erdoganeray/iot-air-conditioner/cnc_paket/hub/2_gorseller/bakir_alt_aynali.png

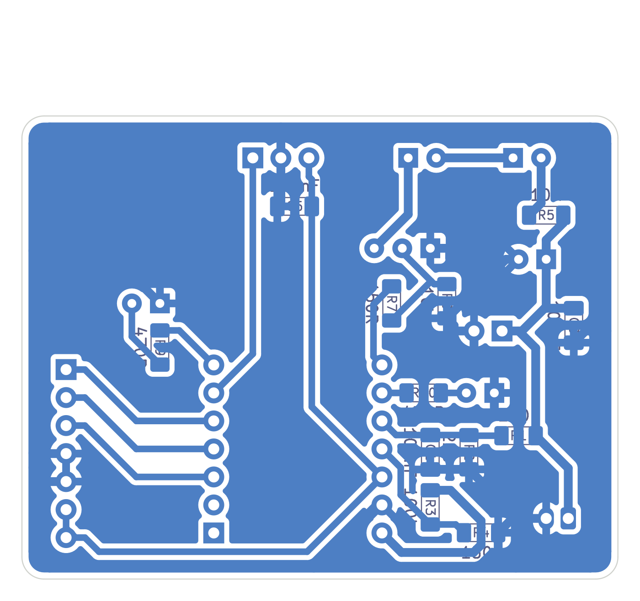
cnc_paket/hub/2_gorseller/bakir_alt_aynali.png
