erdoganeray/iot-air-conditioner/cnc_paket/hub/2_gorseller/yerlesim_ust.png

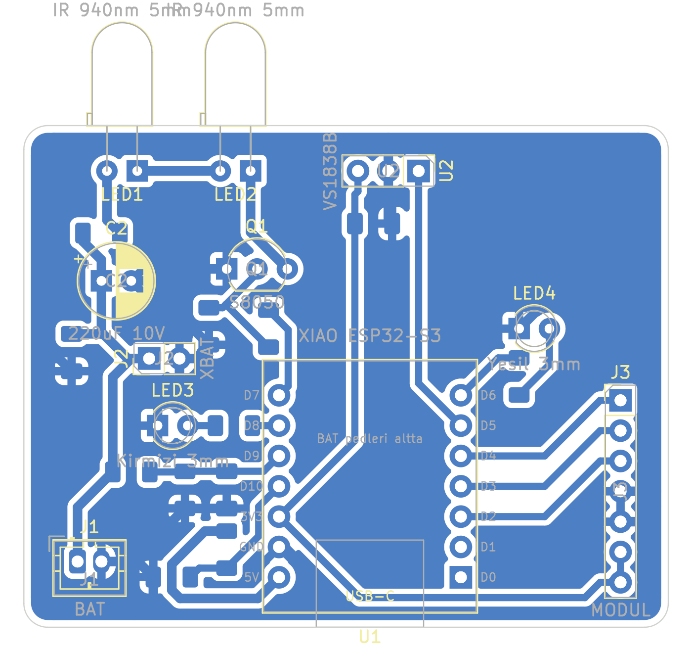
cnc_paket/hub/2_gorseller/yerlesim_ust.png
