erdoganeray/iot-air-conditioner/cnc_paket/sensor/2_gorseller/bakir_alt_aynali.png

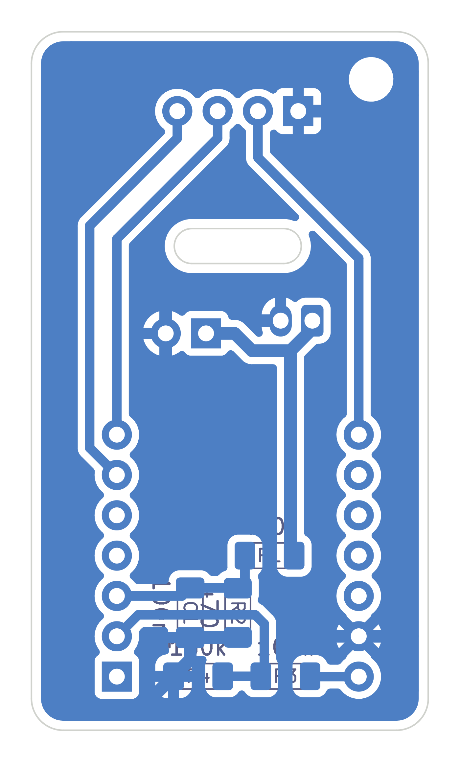
cnc_paket/sensor/2_gorseller/bakir_alt_aynali.png
