erdoganeray/iot-air-conditioner/cnc_paket/sensor/2_gorseller/yerlesim_ust.png

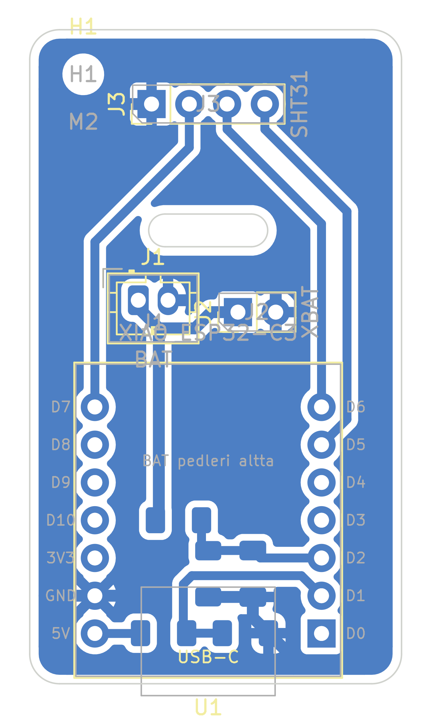
cnc_paket/sensor/2_gorseller/yerlesim_ust.png
