erdoganeray/iot-air-conditioner/enclosure/onizleme/hub_kapali_arka.png

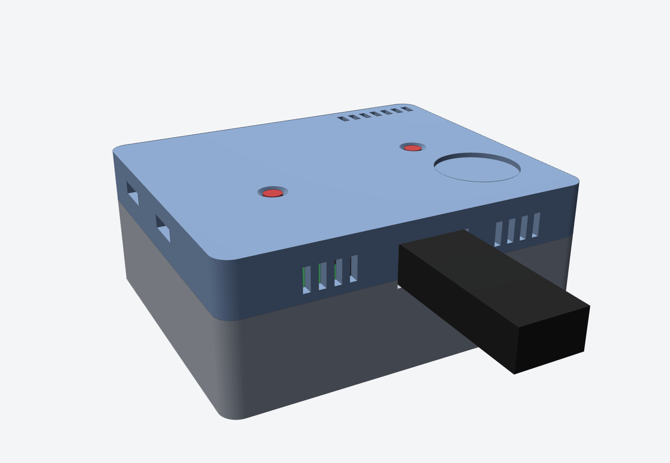
enclosure/onizleme/hub_kapali_arka.png
