erdoganeray/iot-air-conditioner/enclosure/onizleme/hub_kesit.png

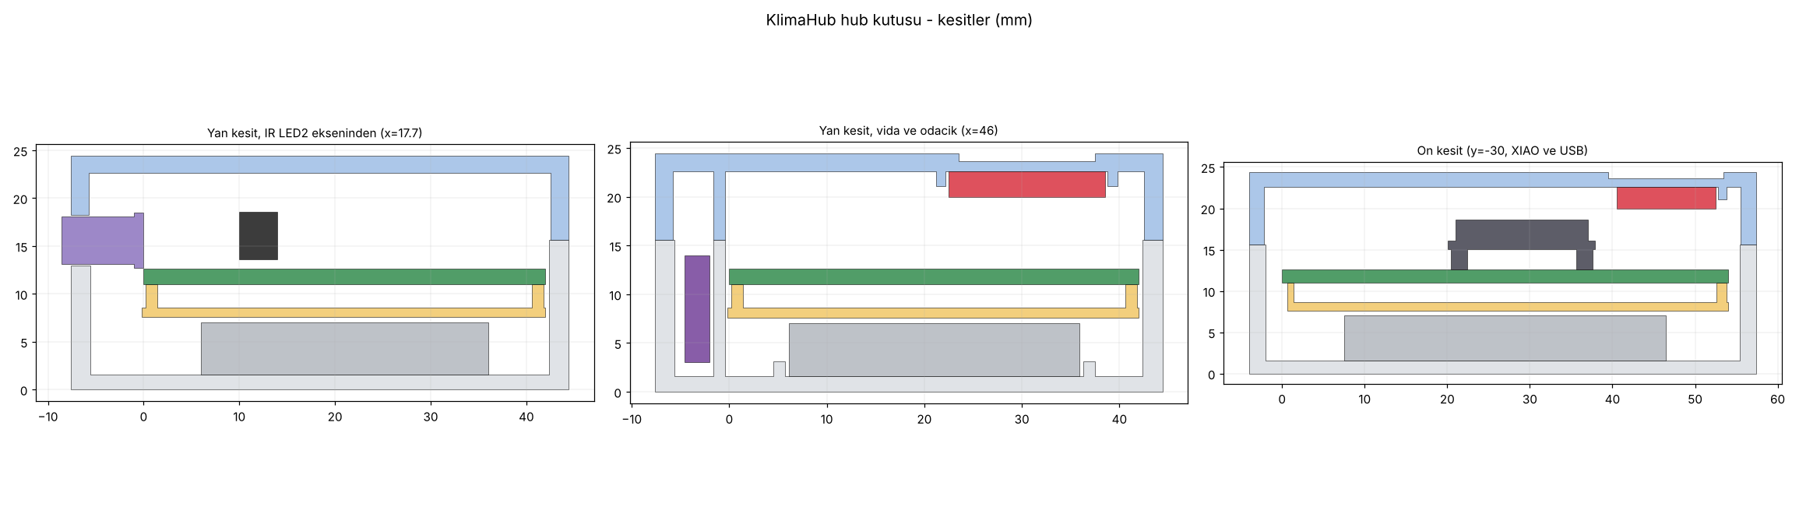
enclosure/onizleme/hub_kesit.png
