erdoganeray/iot-air-conditioner/enclosure/onizleme/sensor_kapali_arka.png

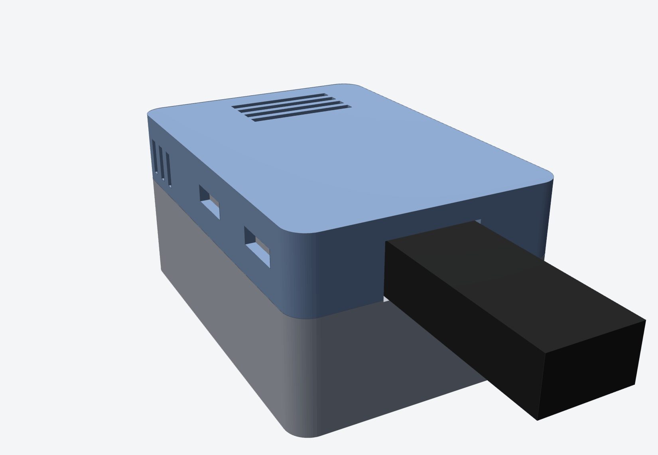
enclosure/onizleme/sensor_kapali_arka.png
