erdoganeray/iot-air-conditioner/enclosure/onizleme/sensor_kesit.png

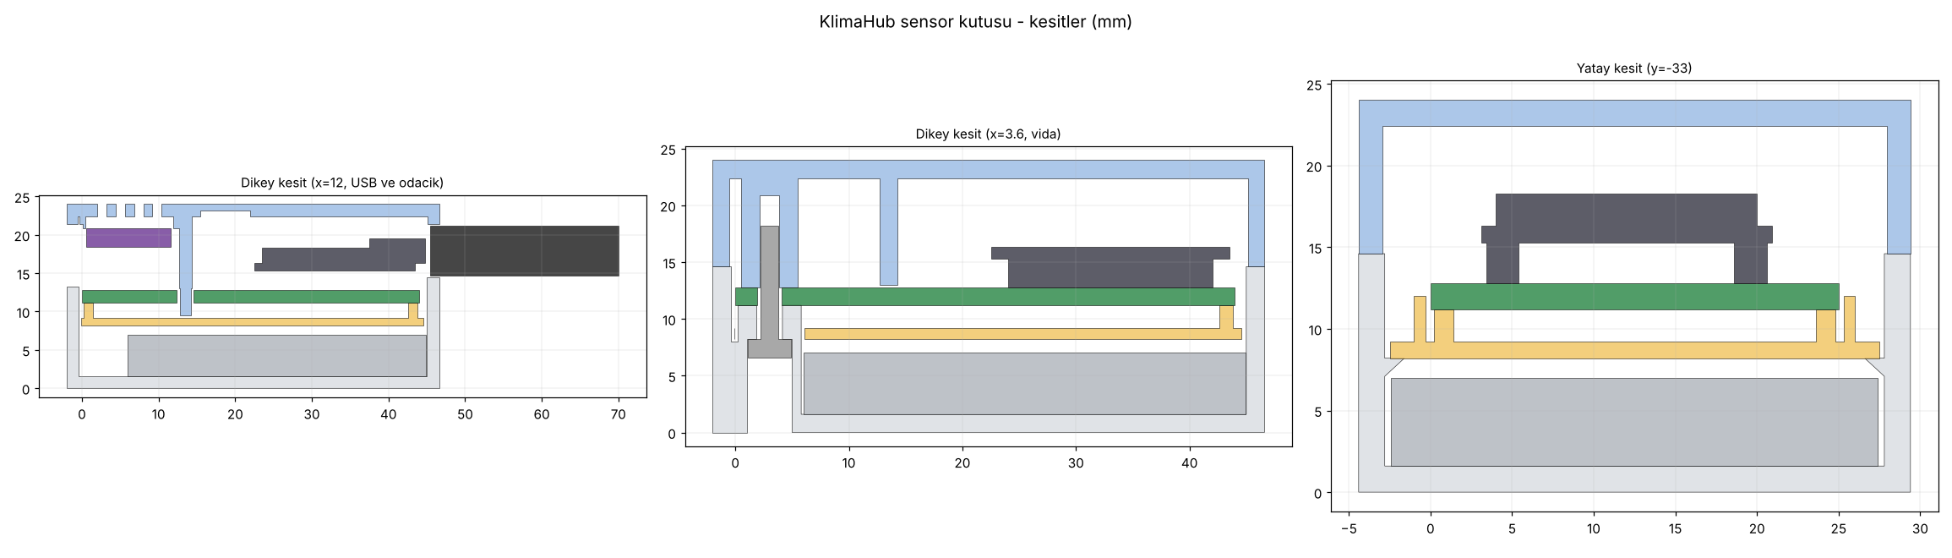
enclosure/onizleme/sensor_kesit.png
