erdoganeray/iot-air-conditioner/pcb/fab/uretim/hub/hub_alt.png

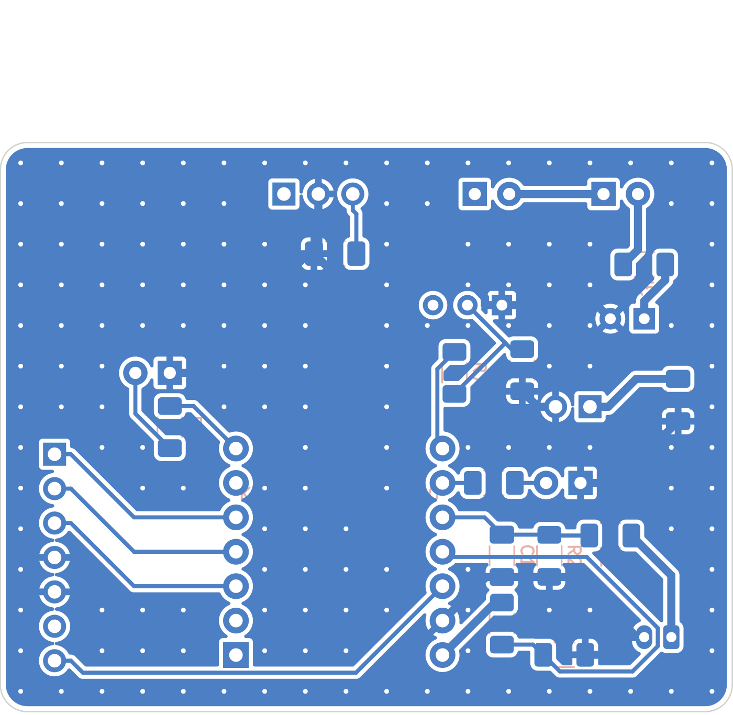
pcb/fab/uretim/hub/hub_alt.png
