erdoganeray/iot-air-conditioner/pcb/fab/uretim/sensor/sensor_alt.png

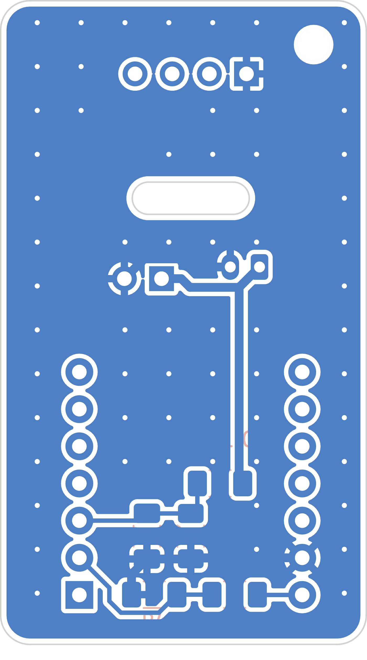
pcb/fab/uretim/sensor/sensor_alt.png
