erdoganeray/iot-air-conditioner/enclosure/hub/hub_montaj.step

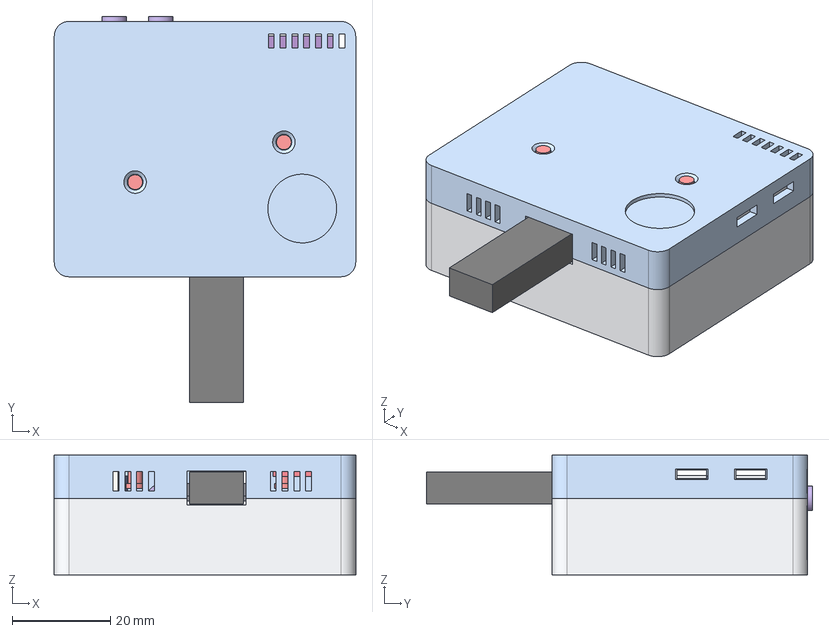
[picture p22: CAD file, 2026-10-21]
enclosure/hub/hub_montaj.step
61.4 x 78.6 x 24.4 mm
alt_govde
kapak
ara_plaka
temsili_kart
temsili_xiao
temsili_usb_fis
temsili_ir_led
temsili_ir_alici
temsili_q1
temsili_c2
temsili_pil_soketi
temsili_durum_led
temsili_ttp223
temsili_sht31
temsili_pil
temsili_vida
