erdoganeray/iot-air-conditioner/enclosure/sensor/sensor_arka_govde.step

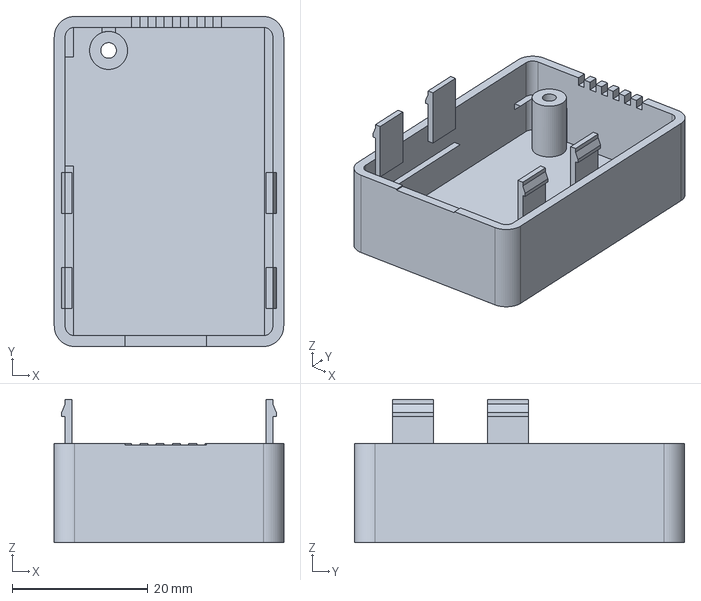
[picture p23: CAD file, 2026-10-21]
enclosure/sensor/sensor_arka_govde.step
33.8 x 48.6 x 21.1 mm
