erdoganeray/iot-air-conditioner/enclosure/hub/hub_kapak.step

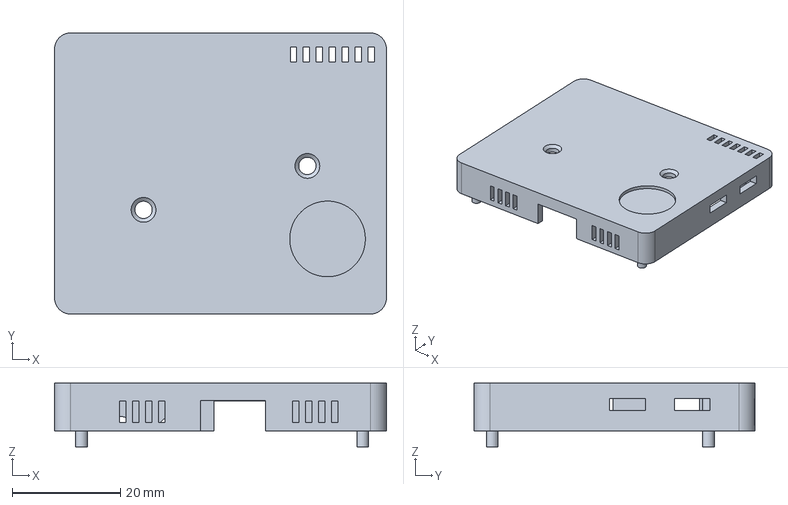
[picture p24: CAD file, 2026-10-21]
enclosure/hub/hub_kapak.step
61.4 x 52.0 x 11.7 mm
