erdoganeray/iot-air-conditioner/enclosure/sensor/sensor_ara_plaka.step

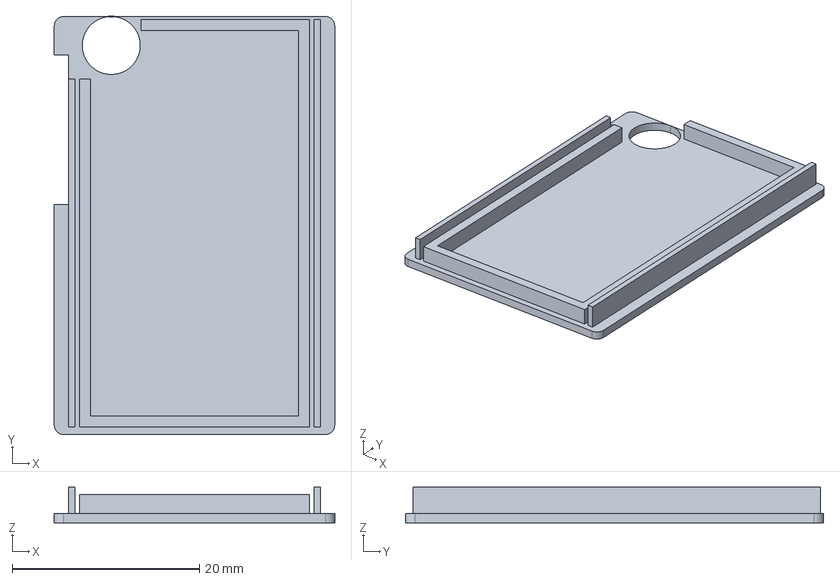
[picture p25: CAD file, 2026-10-21]
enclosure/sensor/sensor_ara_plaka.step
30.0 x 44.7 x 3.80 mm
