erdoganeray/iot-air-conditioner/enclosure/hub/hub_alt_govde.step

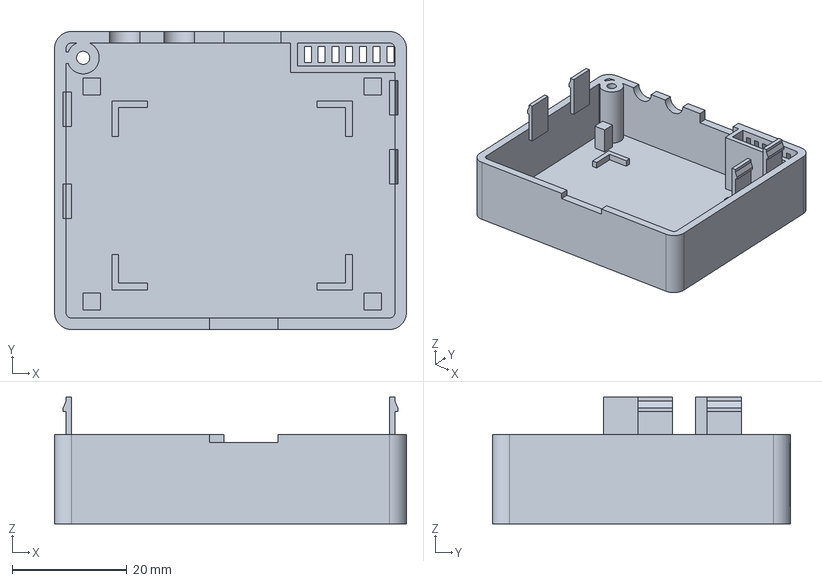
[picture p26: CAD file, 2026-10-21]
enclosure/hub/hub_alt_govde.step
61.4 x 52.0 x 22.1 mm
