erdoganeray/iot-air-conditioner/enclosure/sensor/sensor_on_kapak.step

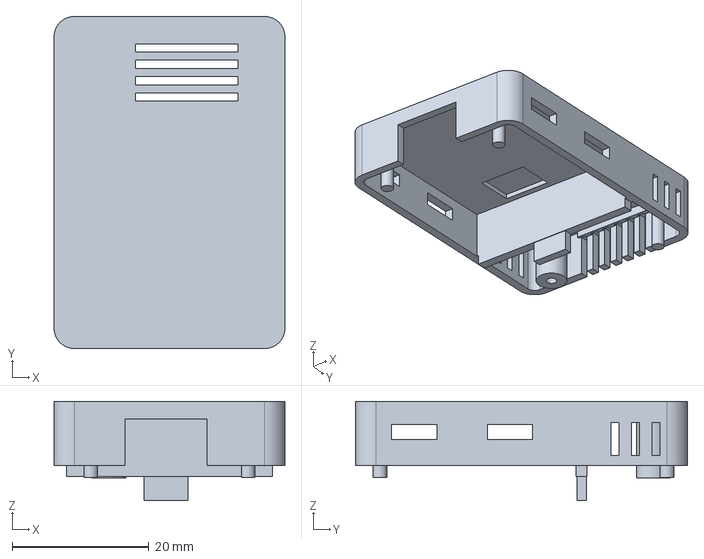
[picture p27: CAD file, 2026-10-21]
enclosure/sensor/sensor_on_kapak.step
33.8 x 48.6 x 14.5 mm
