erdoganeray/iot-air-conditioner/enclosure/hub/hub_ara_plaka.step

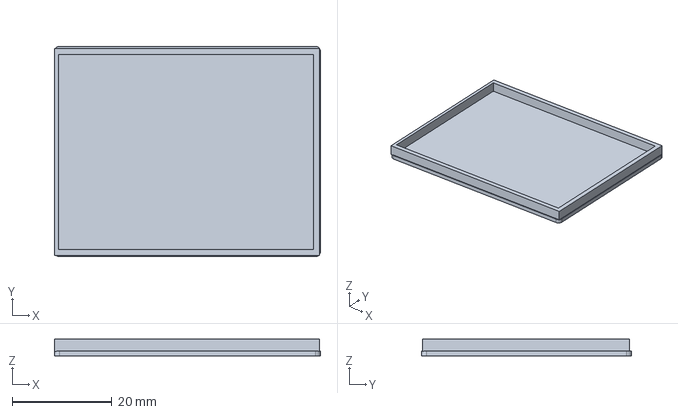
[picture p28: CAD file, 2026-10-21]
enclosure/hub/hub_ara_plaka.step
53.4 x 42.2 x 3.40 mm
