erdoganeray/iot-air-conditioner/enclosure/sensor/sensor_montaj.step

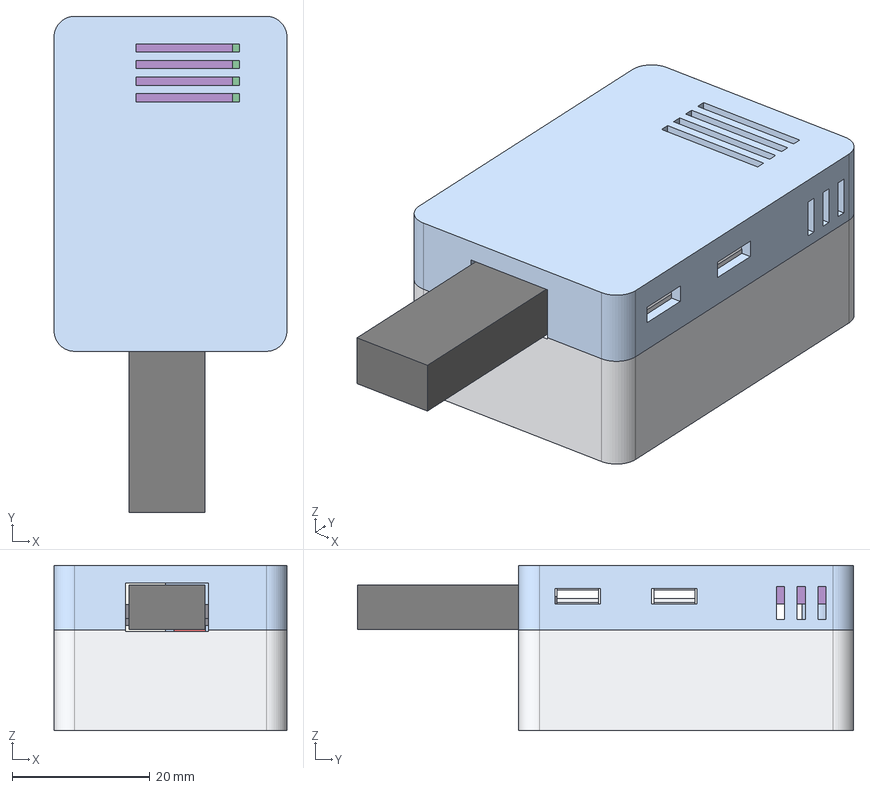
[picture p29: CAD file, 2026-10-21]
enclosure/sensor/sensor_montaj.step
33.8 x 72.0 x 24.0 mm
arka_govde
on_kapak
ara_plaka
temsili_kart
temsili_xiao
temsili_usb_fis
temsili_pil
temsili_sht31
temsili_pil_soketi
temsili_j2_kablo
temsili_vida
