erdoganeray/iot-air-conditioner/(list of files, cad)

Other CAD files:
enclosure/hub/hub_alt_govde.stl
enclosure/hub/hub_ara_plaka.stl
enclosure/hub/hub_kapak.stl
enclosure/sensor/sensor_ara_plaka.stl
enclosure/sensor/sensor_arka_govde.stl
enclosure/sensor/sensor_on_kapak.stl
