erdoganeray/iot-air-conditioner/cnc_paket/yeniden_uretim/pcb/hub/klima-hub.kicad_pcb

## KiCad design cnc_paket/yeniden_uretim/pcb/hub/klima-hub.kicad_pcb (2026-10-21)

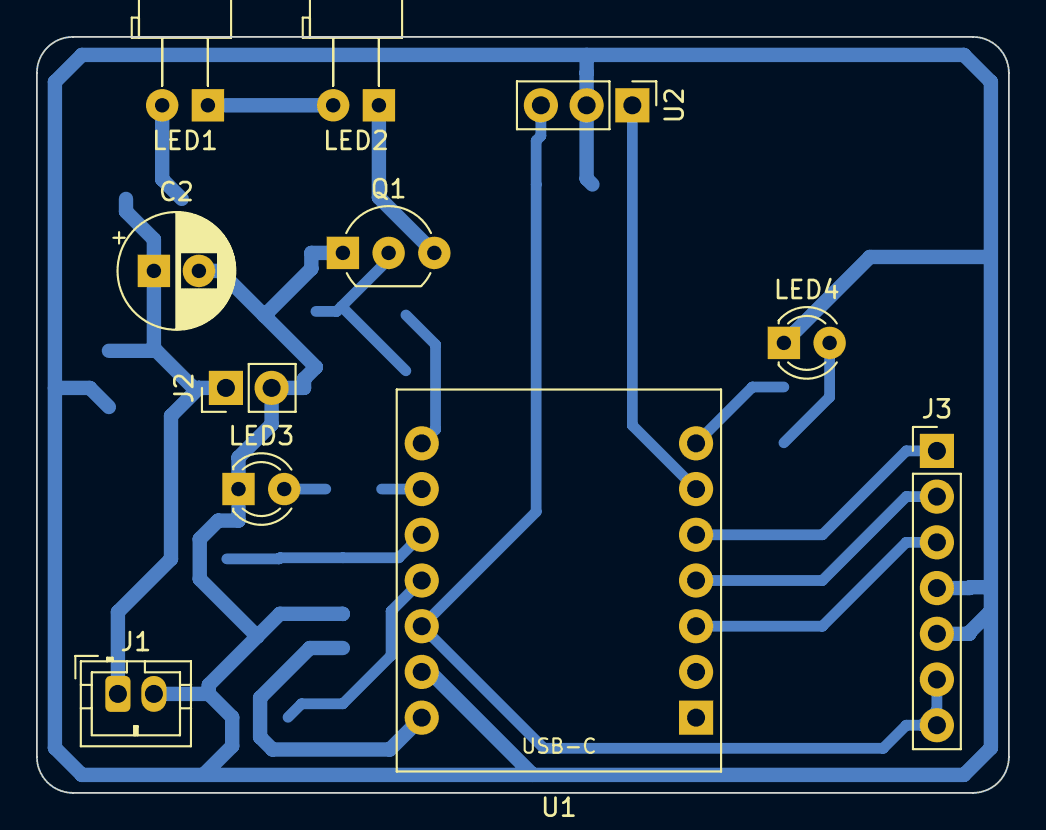
[picture p34: board klima-hub.kicad_pcb from above]

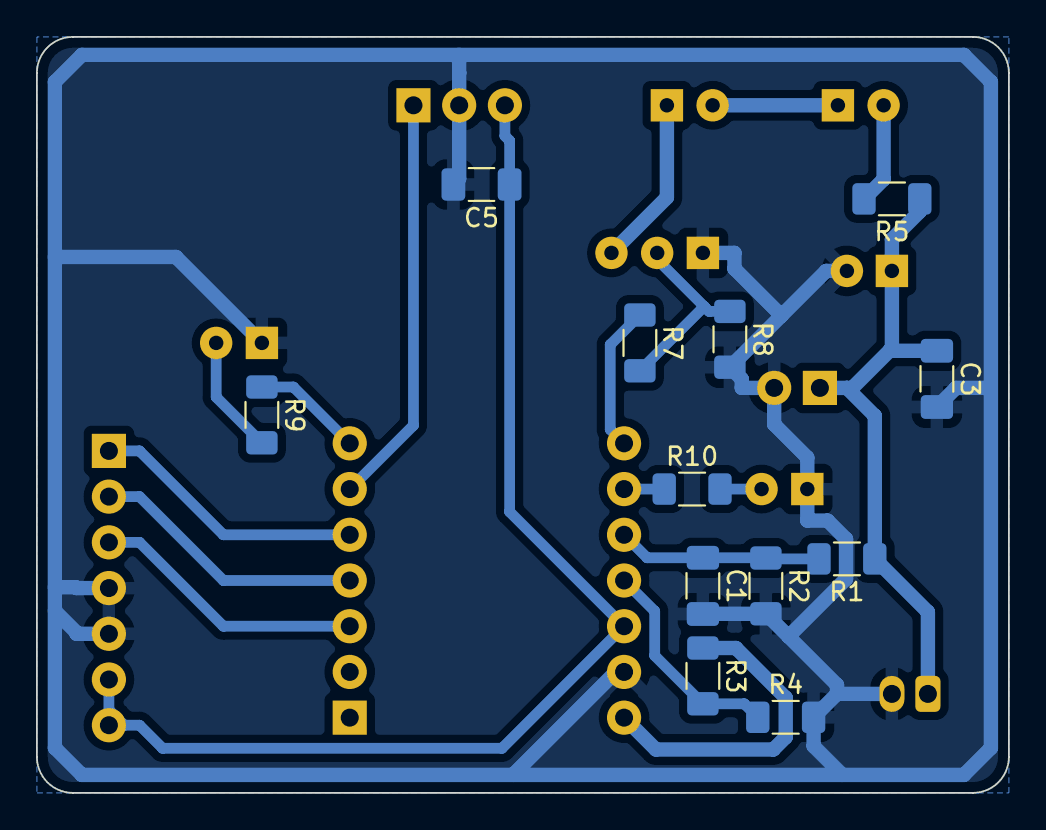
[picture p35: board klima-hub.kicad_pcb from below]

Board: 2 copper layers, 54.0 x 42.0 mm, 23 parts (12 on the bottom side), 19 nets.

Parts:
C1, C3, C5: 100nF; C_1206_3216Metric_Pad1.33x1.80mm_HandSolder
C2: 220uF 10V; CP_Radial_D6.3mm_P2.50mm
J1: BAT; JST_PH_B2B-PH-K_1x02_P2.00mm_Vertical
J2: XBAT; PinHeader_1x02_P2.54mm_Vertical
J3: MODUL; PinHeader_1x07_P2.54mm_Vertical
LED1, LED2: IR 940nm 5mm; LED_D5.0mm_Horizontal_O3.81mm_Z3.0mm
LED3: Kirmizi 3mm; LED_D3.0mm
LED4: Yesil 3mm; LED_D3.0mm
Q1: S8050; TO-92_Inline_Wide
R1, R2: 220k; R_1206_3216Metric_Pad1.30x1.75mm_HandSolder
R3: 100k; R_1206_3216Metric_Pad1.30x1.75mm_HandSolder
R4: 150k; R_1206_3216Metric_Pad1.30x1.75mm_HandSolder
R5: 10R; R_1206_3216Metric_Pad1.30x1.75mm_HandSolder
R7: 150R; R_1206_3216Metric_Pad1.30x1.75mm_HandSolder
R8: 10k; R_1206_3216Metric_Pad1.30x1.75mm_HandSolder
R9, R10: 470R; R_1206_3216Metric_Pad1.30x1.75mm_HandSolder
U1: XIAO ESP32-S3; XIAO_DIP14
U2: VS1838B; PinHeader_1x03_P2.54mm_Vertical

Connections:
+3V3: C5.1, J3.6, J3.7, U1.12, U2.3
BAT_SENSE: C1.1, R1.2, R2.1, U1.10
GND: C1.2, C2.2, C3.2, C5.2, J1.2, J2.2, J3.4, J3.5, LED3.1, LED4.1, Q1.1, R2.2, R4.2, R8.2, U1.13, U2.2
IR_K: LED2.1, Q1.3
IR_MID: LED1.1, LED2.2
IR_RX: U1.6, U2.1
IR_TX: R7.1, U1.8
LED1_A: LED1.2, R5.2
LEDG: LED4.2, R9.2
LEDG_A: R9.1, U1.7
LEDR: LED3.2, R10.2
LEDR_A: R10.1, U1.9
Q1_B: Q1.2, R7.2, R8.1
SCL: J3.3, U1.3
SDA: J3.2, U1.4
TOUCH: J3.1, U1.5
USB_SENSE: R3.2, R4.1, U1.11
VBAT: C2.1, C3.1, J1.1, J2.1, R1.1, R5.1
VBUS: R3.1, U1.14
