erdoganeray/iot-air-conditioner/cnc_paket/yeniden_uretim/pcb/sensor/klima-sensor.kicad_pcb

## KiCad design cnc_paket/yeniden_uretim/pcb/sensor/klima-sensor.kicad_pcb (2026-10-21)

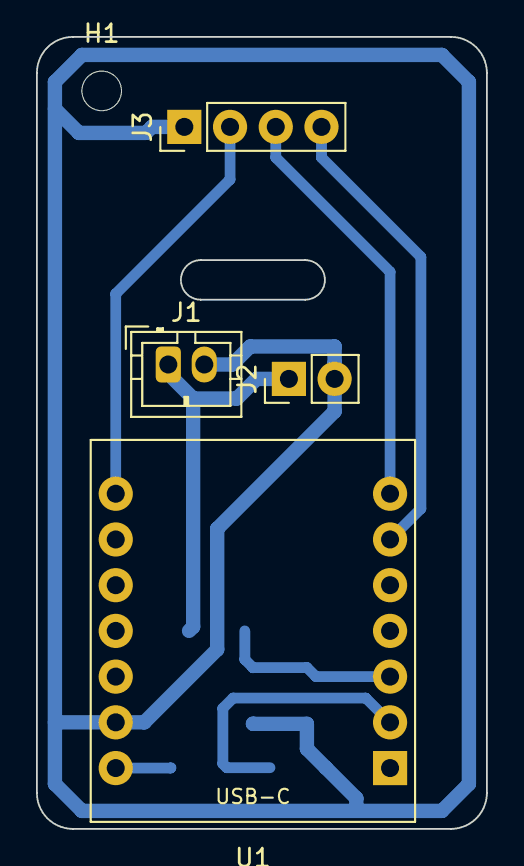
[picture p36: board klima-sensor.kicad_pcb from above]

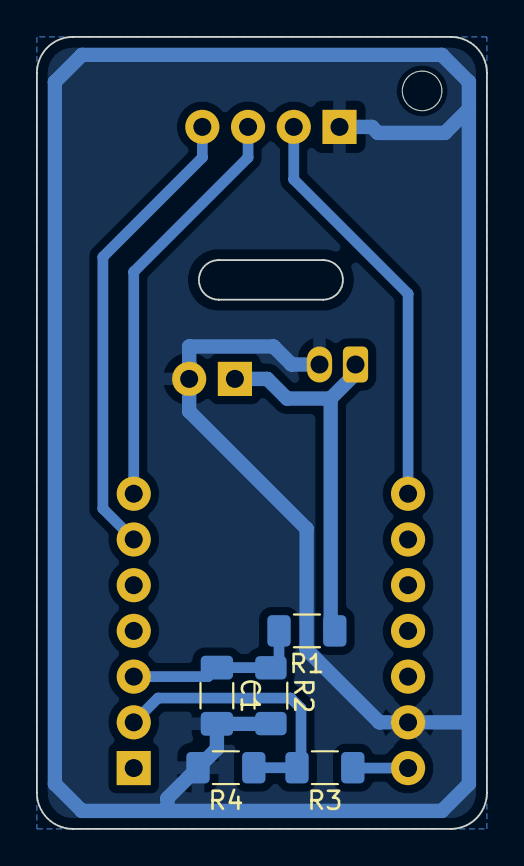
[picture p37: board klima-sensor.kicad_pcb from below]

Board: 2 copper layers, 25.0 x 44.0 mm, 10 parts (5 on the bottom side), 8 nets.

Parts:
C1: 100nF; C_1206_3216Metric_Pad1.33x1.80mm_HandSolder
H1: M2; MountingHole_2.2mm_M2
J1: BAT; JST_PH_B2B-PH-K_1x02_P2.00mm_Vertical
J2: XBAT; PinHeader_1x02_P2.54mm_Vertical
J3: SHT31; PinHeader_1x04_P2.54mm_Vertical
R1, R2: 470k; R_1206_3216Metric_Pad1.30x1.75mm_HandSolder
R3: 100k; R_1206_3216Metric_Pad1.30x1.75mm_HandSolder
R4: 150k; R_1206_3216Metric_Pad1.30x1.75mm_HandSolder
U1: XIAO ESP32-C3; XIAO_DIP14

Connections:
BAT_SENSE: C1.1, R1.2, R2.1, U1.3
GND: C1.2, J1.2, J2.2, J3.1, R2.2, R4.2, U1.13
SCL: J3.4, U1.6
SDA: J3.3, U1.7
SENS_PWR: J3.2, U1.8
USB_SENSE: R3.2, R4.1, U1.2
VBAT: J1.1, J2.1, R1.1
VBUS: R3.1, U1.14
