erdoganeray/iot-air-conditioner/firmware/hub/src/telegram_ca.h

// Telegram API (api.telegram.org) için kök sertifikalar.
// Telegram şu an Go Daddy G2 zincirini kullanır; diğerleri olası bir CA değişikliğine karşı yedektir.
// Kaynak: Mozilla CA paketi (Ubuntu ca-certificates).
#pragma once

static const char kTelegramRootCa[] = R"PEM(
-----BEGIN CERTIFICATE-----
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
4uJEvlz36hz1
-----END CERTIFICATE-----
-----BEGIN CERTIFICATE-----
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
-----END CERTIFICATE-----
-----BEGIN CERTIFICATE-----
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
MrY=
-----END CERTIFICATE-----
-----BEGIN CERTIFICATE-----
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
-----END CERTIFICATE-----
)PEM";
