erdoganeray/iot-air-conditioner/(commit log)

2026-10-21 Add system architecture document
    Pin maps for hub (XIAO ESP32-S3) and sensor (XIAO ESP32-C3), power
    design, ESP-NOW protocol, WiFi resilience strategy, BLE/WebSocket API
    overview, automation logic, LED/touch behaviour.
    Claude-Session: https://claude.ai/code/session_01K7NEXKdzHGt5toAVue95zu
2026-10-21 Add sensor firmware and shared protocol library
    - klima_common: packed ESP-NOW report/ack structs, SHT31 driver with CRC,
    LiPo voltage-to-percent curve
    - sensor: deep-sleep cycle on XIAO ESP32-C3, GPIO-powered SHT31,
    battery/USB sensing, RTC ring buffer for readings while the hub is
    unreachable, ESP-NOW send with ACK, sparse channel scan on failure,
    settings (interval, time, channel) received from the hub
    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
    [main.cpp]
2026-10-21 Add hub core logic with native unit tests
    Pure C++ automation (thermostat, dry mode, schedules, short-cycle
    protection, manual override hold), 7-day history core with dirty
    tracking, shared model types. 20 Unity tests run on the host with
    'pio test -e native'.
    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
    [automation_logic.h, history_core.h, model.h, pins.h]
2026-10-21 Add hub firmware modules
    WiFi manager with exponential backoff, fast reconnect via saved
    channel/BSSID, periodic full stack reset and captive setup AP; ESP-NOW
    receiver task with immediate ACK; hub SHT31 and remote sensor registry;
    IR control (IRac protocol mode with learning/auto-detect, raw command
    learning with roles, passive remote sync); automation runner and
    schedules; JSON API shared by BLE (NUS), WebSocket and USB serial;
    Telegram bot with Turkish commands, inline menu and queued
    notifications; history persistence; LEDs, touch gestures, battery
    monitoring with critical deep sleep; web OTA and ArduinoOTA.
    Builds for seeed_xiao_esp32s3 (flash 78%, RAM 21%).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
    [api.cpp, api.h, app_config.cpp, app_config.h, automation.cpp, automation.h, ble_srv.cpp, ble_srv.h]
2026-10-21 Restore last AC state on boot, burst retry on sensors
    - history: pack fan/swing into AC event log, expose lastAc() so the hub
    restores the believed AC state after a reboot
    - api: cleaner setAc(): settings changed while the AC is off are stored
    as next power-on defaults without sending IR
    - telegram: format update offset with %lld
    - sensor: resend the report in a 400 ms burst until ACK, so the hub can
    catch it even while its radio is time-sliced with Bluetooth
    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
    [api.cpp, history.cpp, history.h, ir_ctrl.cpp, main.cpp, telegram.cpp]
2026-10-21 Add mobile web app (BLE + WebSocket), API docs and CI
    - app/index.html: single-file Turkish PWA, no external dependencies.
    Connects over Web Bluetooth (Nordic UART) or WebSocket when served by
    the hub. Home (AC control, sensor cards, automation toggles), charts
    (7-day history, events), automation editor (thermostat, dry mode,
    schedules), remote learning / protocol selection / raw commands,
    settings (sensors, WiFi scan, Telegram, LEDs, PIN, OTA upload)
    - manifest, service worker and icons for GitHub Pages install
    - app/tools/mock_hub.py: fake hub implementing the full API
    - app/tools/ui_smoke_test.py: headless Chromium smoke test + screenshots
    - docs/API.md: JSON API reference
    - CI: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
2026-10-21 Add hub PCB generator (KiCad + Freerouting, single-sided)
    - pcb/tools/boards.py: placement and netlist for hub and sensor boards
    - pcb/tools/build_pcb.py: builds the KiCad board from code, enlarges THT
    pads for an unplated CNC board, routes on B.Cu only via Freerouting
    (F.Cu blocked by a rule area; optional second pass turns leftovers
    into top-side jumper wires), adds a locked GND ring and a GND pour,
    runs DRC and exports Gerber/Excellon/SVG/PNG
    - pcb/lib/klima.pretty/XIAO_DIP14: XIAO footprint on 2x7 headers
    - Hub: 54x42 mm, zero jumpers, 0 unconnected pads, no copper DRC errors.
    IR LEDs in series from VBAT, simple USB/battery dividers, one 7-pin
    module header for TTP223 + SHT31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
    [klima-hub-B_Cu.gbr, klima-hub-B_Fab.gbr, klima-hub-Edge_Cuts.gbr, klima-hub-F_Fab.gbr, klima-hub-F_Silkscreen.gbr, klima-hub-NPTH.drl, klima-hub-PTH.drl, klima-hub-job.gbrjob]
2026-10-21 Route sensor PCB single-sided with zero jumpers, update pin maps
    - Sensor board 25x44 mm: thermal slot between SHT31 area and XIAO,
    slot keepout so routes keep the edge clearance, GND ring, pin
    assignment chosen for a planar layout (D7 sensor power, D6 SDA,
    D5 SCL, D2 battery ADC, D1 USB sense)
    - Hub firmware pins.h and sensor firmware updated to the PCB pin maps
    - Placement checker reports pad clearance problems before routing
    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
    [klima-sensor-B_Cu.gbr, klima-sensor-B_Fab.gbr, klima-sensor-Edge_Cuts.gbr, klima-sensor-F_Fab.gbr, klima-sensor-F_Silkscreen.gbr, klima-sensor-NPTH.drl, klima-sensor-PTH.drl, klima-sensor-job.gbrjob]
2026-10-21 Add CNC G-code generator for Candle/GRBL
    Mirrored bottom-copper isolation (multi-pass V-bit), per-diameter and
    single-bit drill files, tabbed cutouts for 1.0/2.0/3.175 mm end mills,
    V-bit score alternative, previews and post-milling short/open check.
    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
2026-10-21 Add M2 mounting hole to sensor PCB, mill NPTH holes in cutout
    The enclosure screw passes through the sensor board and clamps it
    between the back shell and the front cover. Routing is unchanged
    (zero jumpers, no copper DRC errors).
    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
    [klima-sensor-B_Cu.gbr, klima-sensor-B_Fab.gbr, klima-sensor-Edge_Cuts.gbr, klima-sensor-F_Fab.gbr, klima-sensor-F_Silkscreen.gbr, klima-sensor-NPTH.drl, klima-sensor-PTH.drl, klima-sensor-job.gbrjob]
2026-10-21 Add 3D-printable enclosures for hub and sensors
    CadQuery source generates base, cover and battery separator plate as
    STL and STEP, plus assembly STEP with placeholder components. Snap-fit
    covers with four fingers and one M2 screw, IR LED half-holes on the
    split line, ventilated SHT31 chambers, USB-C openings. The build runs
    an interference check against PCB, battery and component envelopes and
    renders previews and a standalone three.js viewer.
    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
    [hub_alt_govde.step, hub_alt_govde.stl, hub_ara_plaka.step, hub_ara_plaka.stl, hub_kapak.step, hub_kapak.stl, hub_montaj.step, sensor_ara_plaka.step]
2026-10-21 Update architecture doc, add bill of materials, harden tooling
    - Architecture doc now matches the routed boards: pin maps, series IR
    LEDs fed from VBAT, connector pinouts, sensor burst timing, PCB and
    enclosure sections
    - Turkish bill of materials with store search terms and LiPo polarity
    warning
    - SHT31 driver probes both 0x44 and 0x45
    - PCB builder: optional locked pre-routes, trial GND fill before the
    jumper phase, and removal of jumpers the pour already covers
    - Document why the IR receiver footprint orientation is correct
    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
    [boards.py, build_pcb.py]
2026-10-21 Add CNC, assembly and setup guides, prebuilt firmware
    - CNC guide for Candle: zeroing, heightmap, tool order, V-bit width
    table, regeneration options and FlatCAM alternative
    - Assembly guide with readable top/bottom assembly maps generated from
    the boards (pin-1 and polarity marks, SMD values)
    - Setup guide: browser or PlatformIO flashing, GitHub Pages, BLE and
    WiFi onboarding, IR learning, sensors, automation, Telegram
    - PlatformIO post-build step writes a merged image flashable at 0x0;
    CI uploads it, and prebuilt 1.0.0 images are committed for the first
    flash
    Claude-Session: https://claude.ai/code/session_01K7NEXKdzHGt5toAV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
2026-10-21 Add morning report, expand README, reframe enclosure previews
    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
2026-10-21 Use a safer IR resistor suggestion in the report
    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
2026-10-22 Add two-layer fabrication version of hub and sensor PCBs
    Same outline, placement and pinout as the CNC boards so enclosures,
    firmware and assembly maps stay valid. Two copper layers with plated
    holes, 0.3/0.6 mm tracks, 0.2 mm clearance, GND pours on both sides
    with stitching vias, solder mask and silkscreen marks (polarity, XIAO
    and J3 pin names). Fully routed, no copper DRC errors. Gerber zips for
    ordering plus a Turkish ordering guide.
    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
    [klima-hub-fab-B_Cu.gbl, klima-hub-fab-B_Mask.gbs, klima-hub-fab-B_Paste.gbp, klima-hub-fab-B_Silkscreen.gbo, klima-hub-fab-Edge_Cuts.gm1, klima-hub-fab-F_Cu.gtl, klima-hub-fab-F_Mask.gts, klima-hub-fab-F_Paste.gtp]
2026-10-22 Add Turkish purchase list with three ready store carts
    docs/SATIN_ALMA.md lists e-Komponent, Robolink and Hepsiburada carts
    with links, quantities, prices (checked 22 Oct 2026) and totals, plus
    the part substitutions (SHT30, TSOP38238, PN2222A, 8x5 mm cap, 503030
    battery). BOM, assembly guide and README link to it.
    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
2026-10-27 CNC mekanikçi paketi ekle (gerber, görseller, hazır G-code, açıklama)
    Claude-Session: https://claude.ai/code/session_01PdcLapo6vGwrUtypWi8oWF
    [klima-hub.kicad_pcb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]
